malfalf/CurrentSinkOrSwim/README.md

# CurrentSinkOrSwim
Building a Current Sink for battery testing in Contextual Electronics
