malfalf/CurrentSinkOrSwim/CurrentSinkOrSwim.csv

ref | value | footprint | Campo1 | Campo2 | Campo3 | Campo4 | Campo5
C301 | .1 | ~
C401 | .1 | ~
C402 | .1 | ~
D201 | DIODE | ~ | 1N4148WT-7
K101 | CONN_3
P101 | CONN_2 |  | CTB5000/2
P102 | CONN_2 |  | CTB5000/2
P301 | HEATSINK |  | 637-10ABEP
Q301 | BUK7575 | ~ | BUK7575-100A
R201 | 28,7K | ~
R202 | 9K | ~
R203 | 1K | ~
R301 | 68K | ~
R302 | 1K | ~
R303 | 0.1 | ~ | LVR01R1000FE12
R401 | 0 | ~
R402 | 27K | ~
R403 | 21.6K | ~
RV201 | POT | ~ | ALPS 29 0001 POTENCIOMETRO
RV301 | POT | ~ | ALPS 29 0001 POTENCIOMETRO
U201 | LMV358 |  | LMV358ID | http://www.farnell.com/datasheets/1862405.pdf
U401 | LM2931ACDG | ~ | LM2931ACDG
