malfalf/CurrentSinkOrSwim/CurrentSinkOrSwim/CurrentSinkOrSwim.kicad_pcb

## KiCad design CurrentSinkOrSwim/CurrentSinkOrSwim.kicad_pcb (2015-10-06)

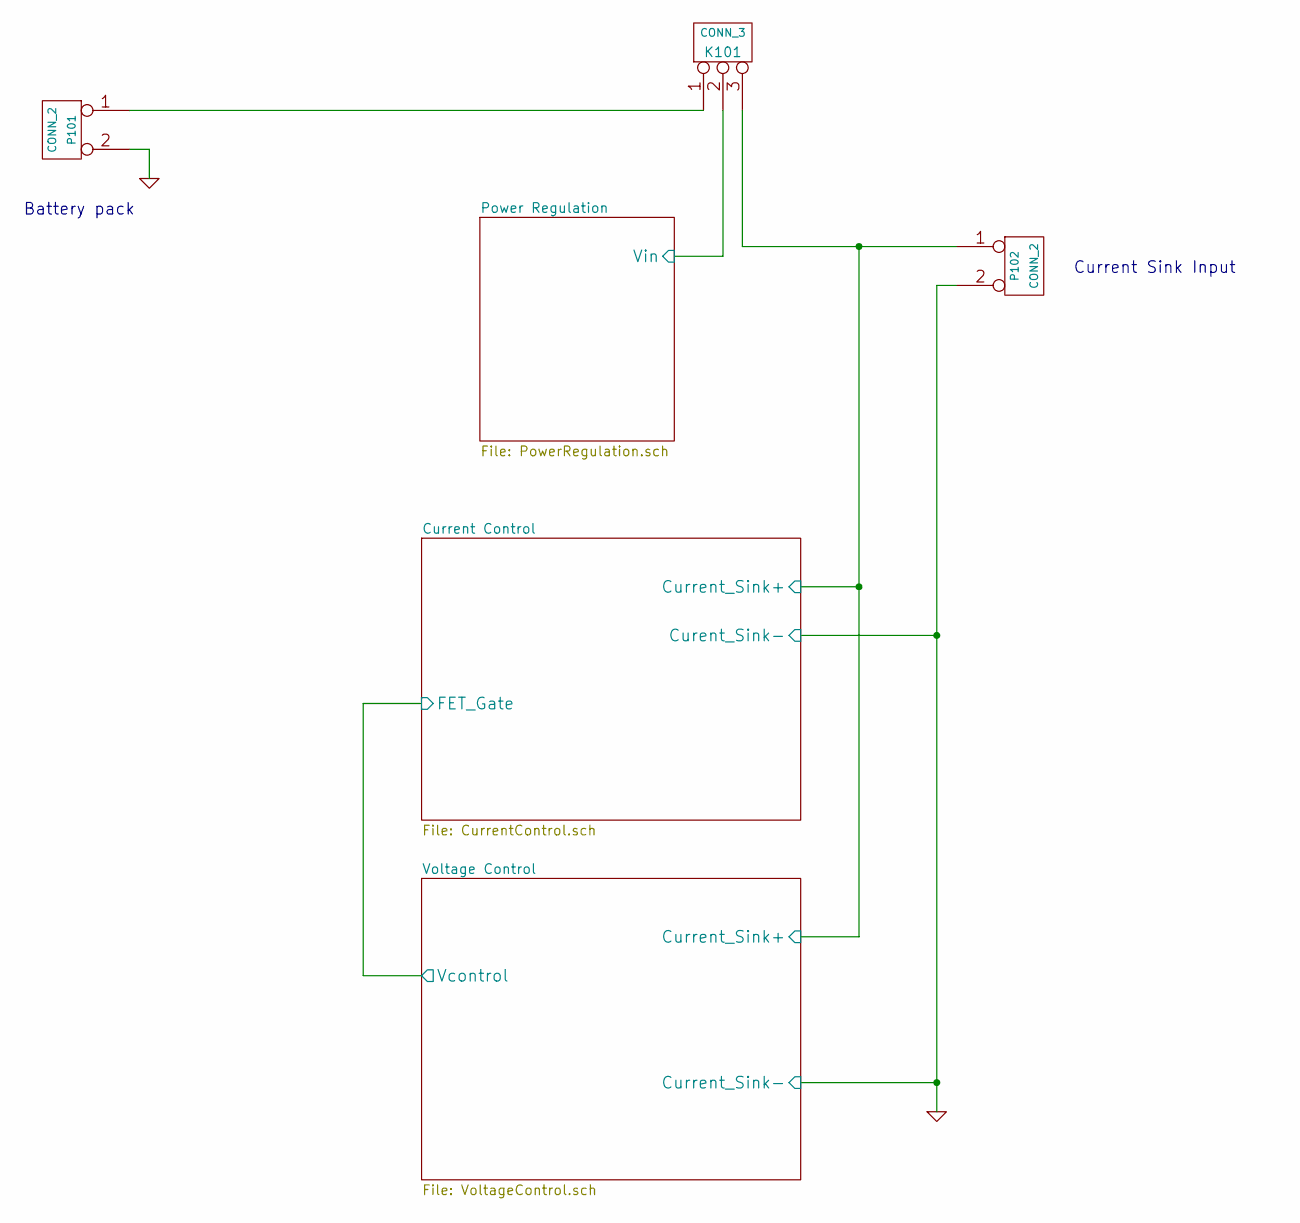
[picture p1: schematic CurrentSinkOrSwim.sch]

Parts:
K101: CONN_3
P101, P102: CONN_2

Connections:
/Current Control/Current_Sink+: K101.3, P102.1; also elsewhere on the board
/Power Regulation/Vin: K101.2 (PM); also elsewhere on the board
GND: P101.2 (PM), P102.2 (PM); also elsewhere on the board
unnamed: K101.1, P101.1

Notes on the sheet:
Current Sink Input
Battery pack

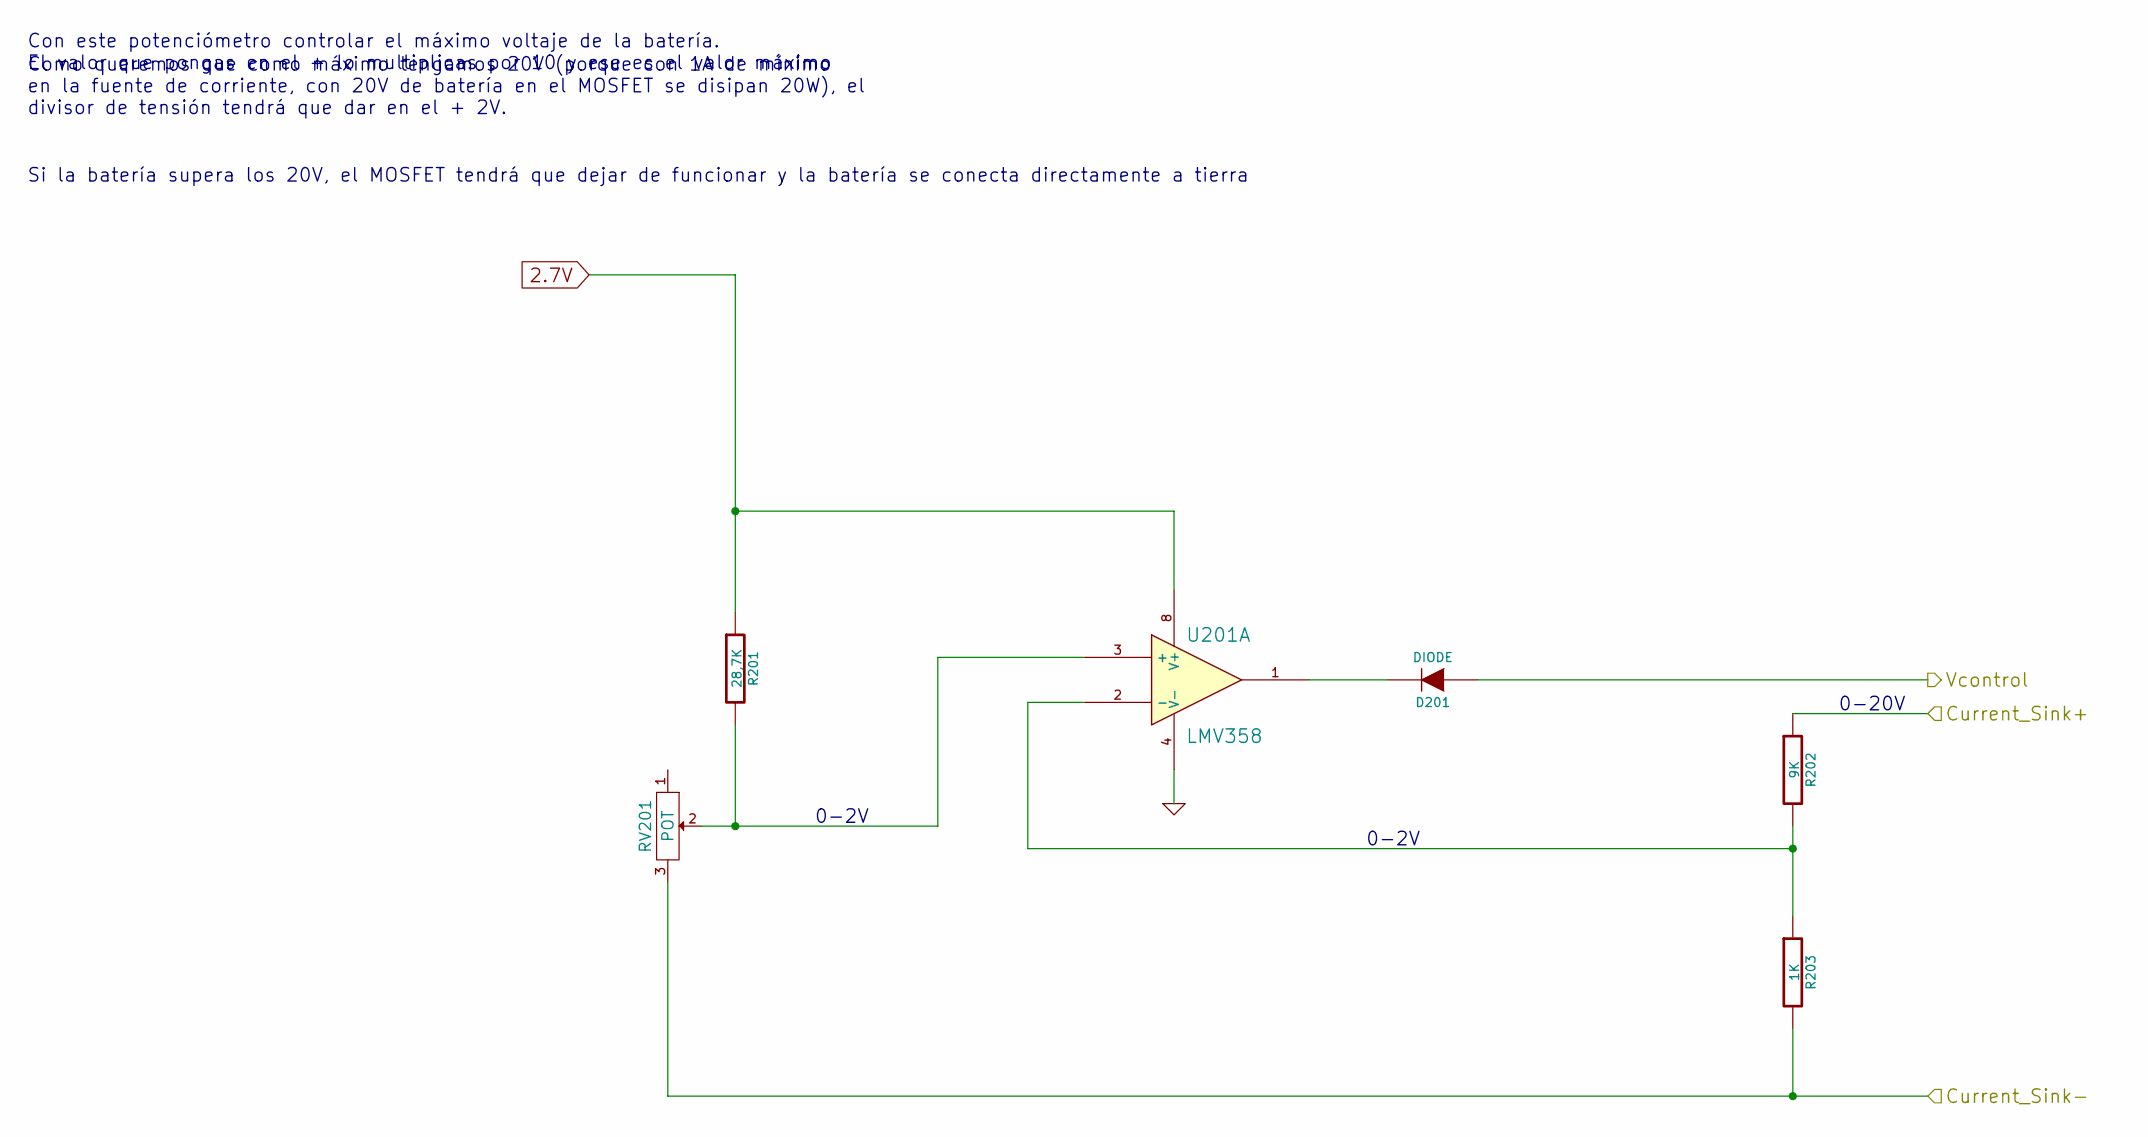
[picture p2: schematic VoltageControl.sch]

Parts:
D201: DIODE
R201: 28,7K
R202: 9K
R203: 1K
RV201: POT
U201: LMV358

Connections:
2.7V: R201.1, U201.8 (V+); also elsewhere on the board
/Current Control/Current_Sink+: R202.1; also elsewhere on the board
/Current Control/FET_Gate: D201.1 (A); also elsewhere on the board
GND: R203.2, RV201.3, U201.4 (V-); also elsewhere on the board
unnamed: R202.2, R203.1, U201.2 (-)
unnamed: D201.2 (K), U201.1
unnamed: R201.2, RV201.2, U201.3 (+)

Notes on the sheet:
Con este potenciómetro controlar el máximo voltaje de la batería. El valor que pongas en el + lo multiplicas por 10 y ese es el valor máximo
Como queremos que como máximo tengamos 20V (porque con 1A de mínimo en la fuente de corriente, con 20V de batería en el MOSFET se disipan 20W), el divisor de tensión tendrá que dar en el + 2V.
Si la batería supera los 20V, el MOSFET tendrá que dejar de funcionar y la batería se conecta directamente a tierra
0-2V
0-20V

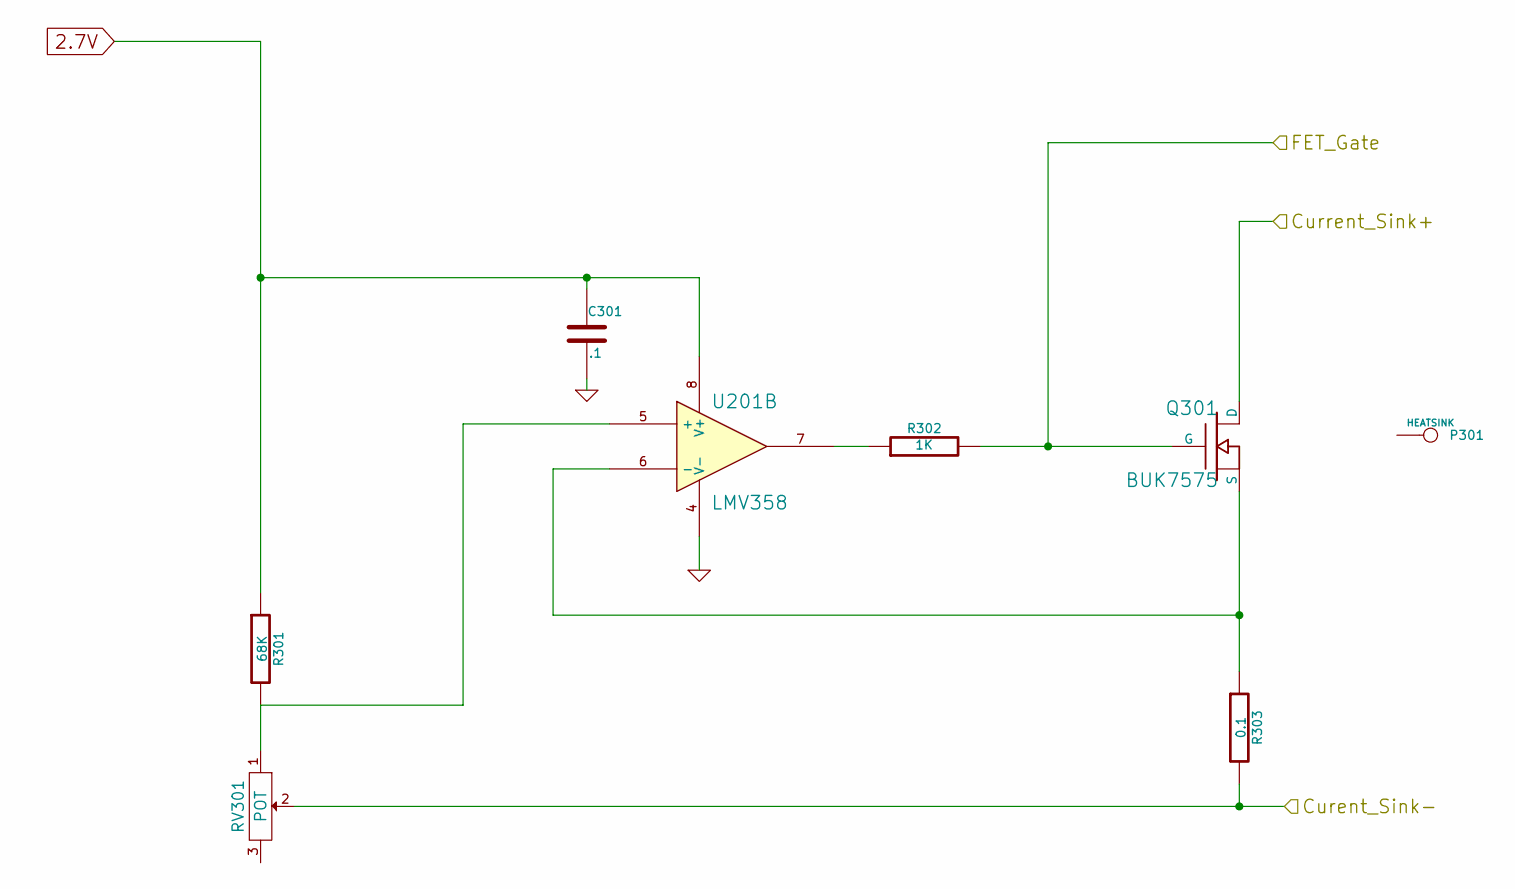
[picture p3: schematic CurrentControl.sch]

Parts:
C301: .1
P301: HEATSINK
Q301: BUK7575; MFG Part Number BUK7575-100A
R301: 68K
R302: 1K
R303: 0.1; MFG Part Number LVR01R1000FE12
RV301: POT
U201: LMV358

Connections:
2.7V: C301.1, R301.1, U201.8 (V+); also elsewhere on the board
/Current Control/Current_Sink+: Q301.D; also elsewhere on the board
/Current Control/FET_Gate: Q301.G, R302.2; also elsewhere on the board
GND: C301.2, R303.2, RV301.2, U201.4 (V-); also elsewhere on the board
unnamed: R302.1, U201.7
unnamed: R301.2, RV301.1, U201.5 (+)
unnamed: Q301.S, R303.1, U201.6 (-)

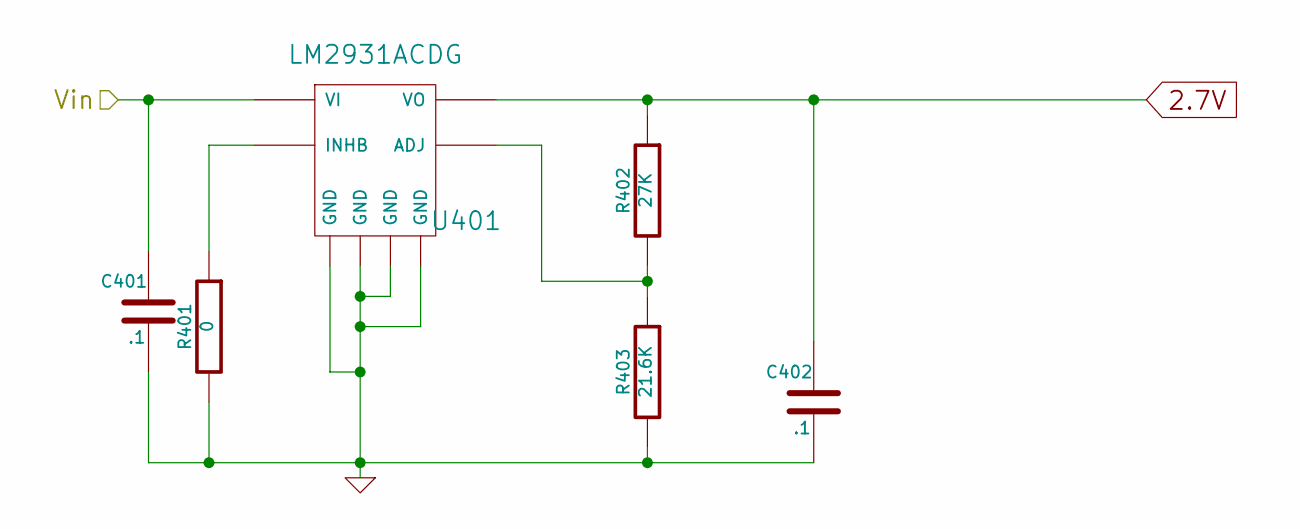
[picture p4: schematic PowerRegulation.sch]

Parts:
C401, C402: .1
R401: 0
R402: 27K
R403: 21.6K
U401: LM2931ACDG

Connections:
2.7V: C402.1, R402.1, U401.1 (VO); also elsewhere on the board
/Power Regulation/Vin: C401.1, U401.8 (VI); also elsewhere on the board
GND: C401.2, C402.2, R401.2, R403.2, U401.2 (GND), U401.3 (GND), U401.6 (GND), U401.7 (GND); also elsewhere on the board
unnamed: R401.1, U401.5 (INHB)
unnamed: R402.2, R403.1, U401.4 (ADJ)

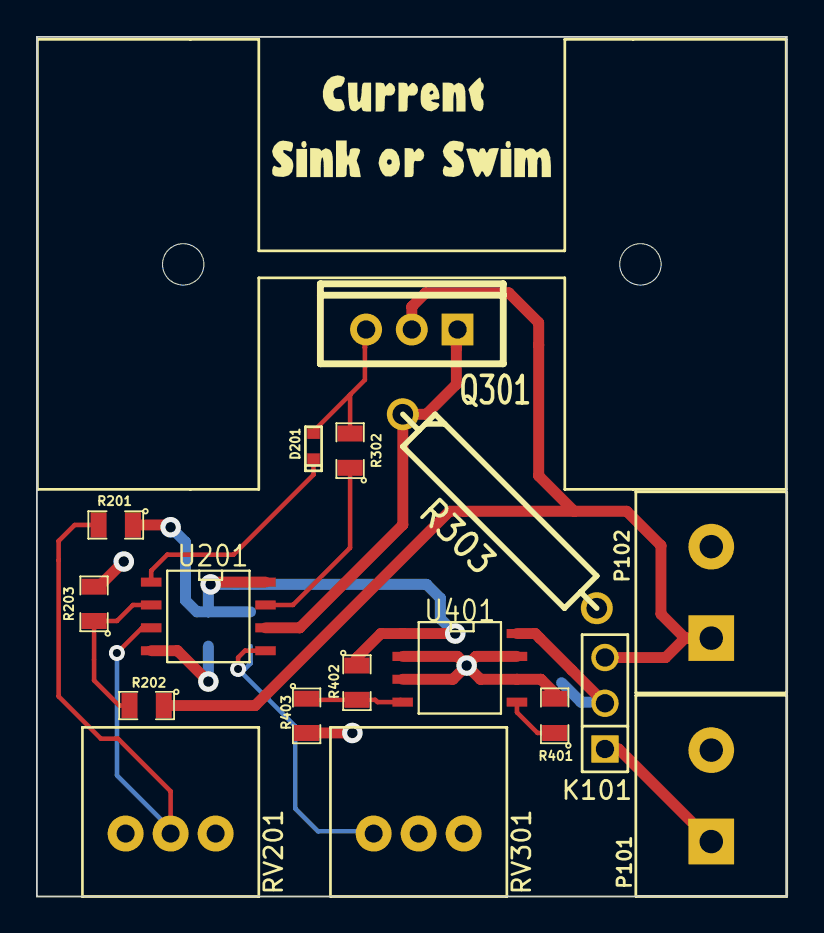
[picture p5: board CurrentSinkOrSwim.kicad_pcb from above]

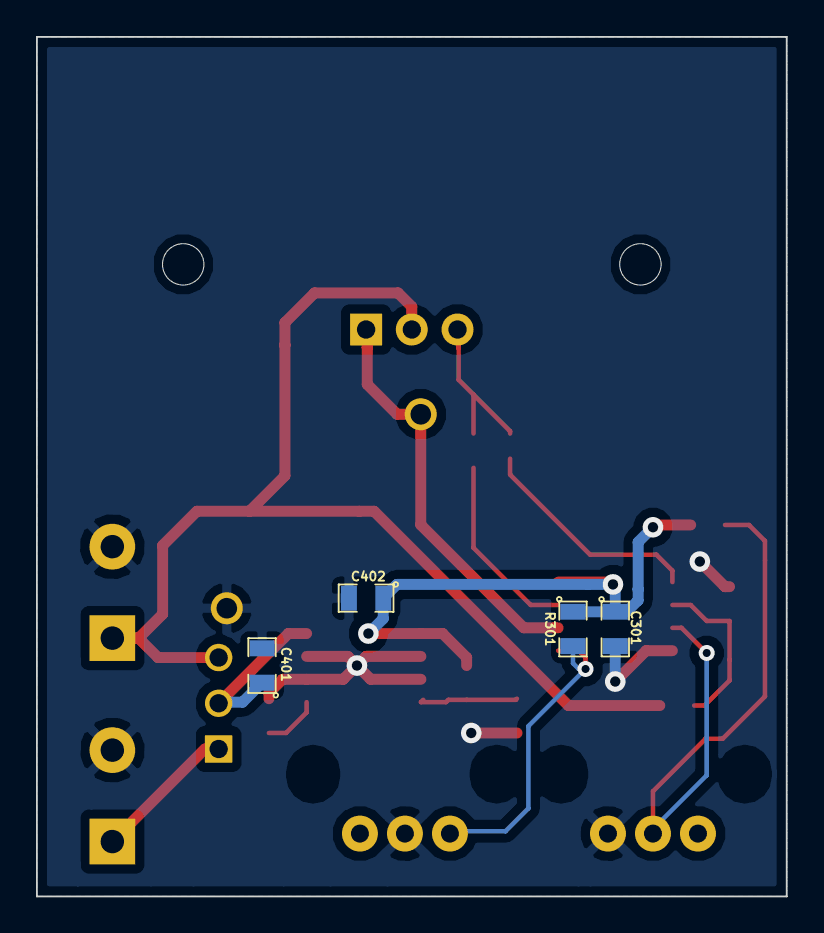
[picture p6: board CurrentSinkOrSwim.kicad_pcb from below]

Board: 2 copper layers, 41.7 x 47.8 mm, 22 parts (4 on the bottom side), 14 nets.
