malfalf/CurrentSinkOrSwim/(commit log)

2015-08-21 KiCad project and schematic creation
    [CurrentSinkOrSwim.sch]
2015-08-21 Adding preliminary components (without values) to the schematic
    [CurrentSinkOrSwim.sch]
2015-09-01 Modificado el esquemático (cambiando el LDO)
2015-09-01 Subo los archivos de simulación LTSpice
2015-09-01 adding new sheets
    [CurrentControl.sch, CurrentSinkOrSwim.sch, PowerRegulation.sch, VoltageControl.sch]
2015-09-06 Schematic annotate
    [CurrentControl.sch, CurrentSinkOrSwim.sch, PowerRegulation.sch, VoltageControl.sch]
2015-09-06 Cambios en la simulación
2015-09-06 Añadiendo net list, footprints y nombres a los componentes que no lo tenían. Empezando con el layout
    [CurrentSinkOrSwim.kicad_pcb, CurrentSinkOrSwim.sch, PowerRegulation.sch, VoltageControl.sch]
2015-09-09 creado footprint heatsink
    [CurrentControl.sch, CurrentSinkOrSwim.kicad_pcb, CurrentSinkOrSwim.sch]
2015-09-19 Cambiados footprints del potenciometro
    [CurrentSinkOrSwim.kicad_pcb]
2015-09-19 cambiando potenciómetro y divisores de tension
    [CurrentControl.sch, CurrentSinkOrSwim.sch, PowerRegulation.sch, VoltageControl.sch]
2015-09-19 placing components in the PCB
    [CurrentControl.sch, CurrentSinkOrSwim.kicad_pcb, CurrentSinkOrSwim.sch, PowerRegulation.sch, VoltageControl.sch]
2015-09-21 first layout session
    [CurrentSinkOrSwim.kicad_pcb]
2015-09-24 Layout session 2
    [CurrentControl.sch, CurrentSinkOrSwim.kicad_pcb, CurrentSinkOrSwim.sch, PowerRegulation.sch, VoltageControl.sch]
2015-09-26 Design Rule Check
    [CurrentSinkOrSwim.kicad_pcb]
2015-09-26 generando los ficheros Gerber y metiendo el logo
    [CurrentSinkOrSwim.kicad_pcb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]
2015-09-26 Creados de nuevo los ficheros Gerber, cambiando alguna línea de los footprints de los potenciómetros y fusionando en un único documento el gerber de los taladros para que lo reconozco OSHpark
    [CurrentSinkOrSwim-All-Drills.drl, CurrentSinkOrSwim-B_Cu.gbl, CurrentSinkOrSwim-B_Mask.gbs, CurrentSinkOrSwim-B_SilkS.gbo, CurrentSinkOrSwim-Edge_Cuts.gko, CurrentSinkOrSwim-F_Cu.gtl, CurrentSinkOrSwim-F_Mask.gts, CurrentSinkOrSwim-F_SilkS.gto]
2015-10-01 Actualizando información de los componentes y creando el BOM
    [CurrentControl.sch, CurrentSinkOrSwim.csv, CurrentSinkOrSwim.sch, PowerRegulation.sch, VoltageControl.sch]
2015-10-06 Haciendo algunos cambios porque he tenido que cambiar de componentes y algún valor estaba mal
    [CurrentControl.sch, CurrentSinkOrSwim.csv, CurrentSinkOrSwim.kicad_pcb, CurrentSinkOrSwim.sch, PowerRegulation.sch, VoltageControl.sch]
